kenkawakenkenke/tempescope/hardware/OpenTempescope/opentempescope.png

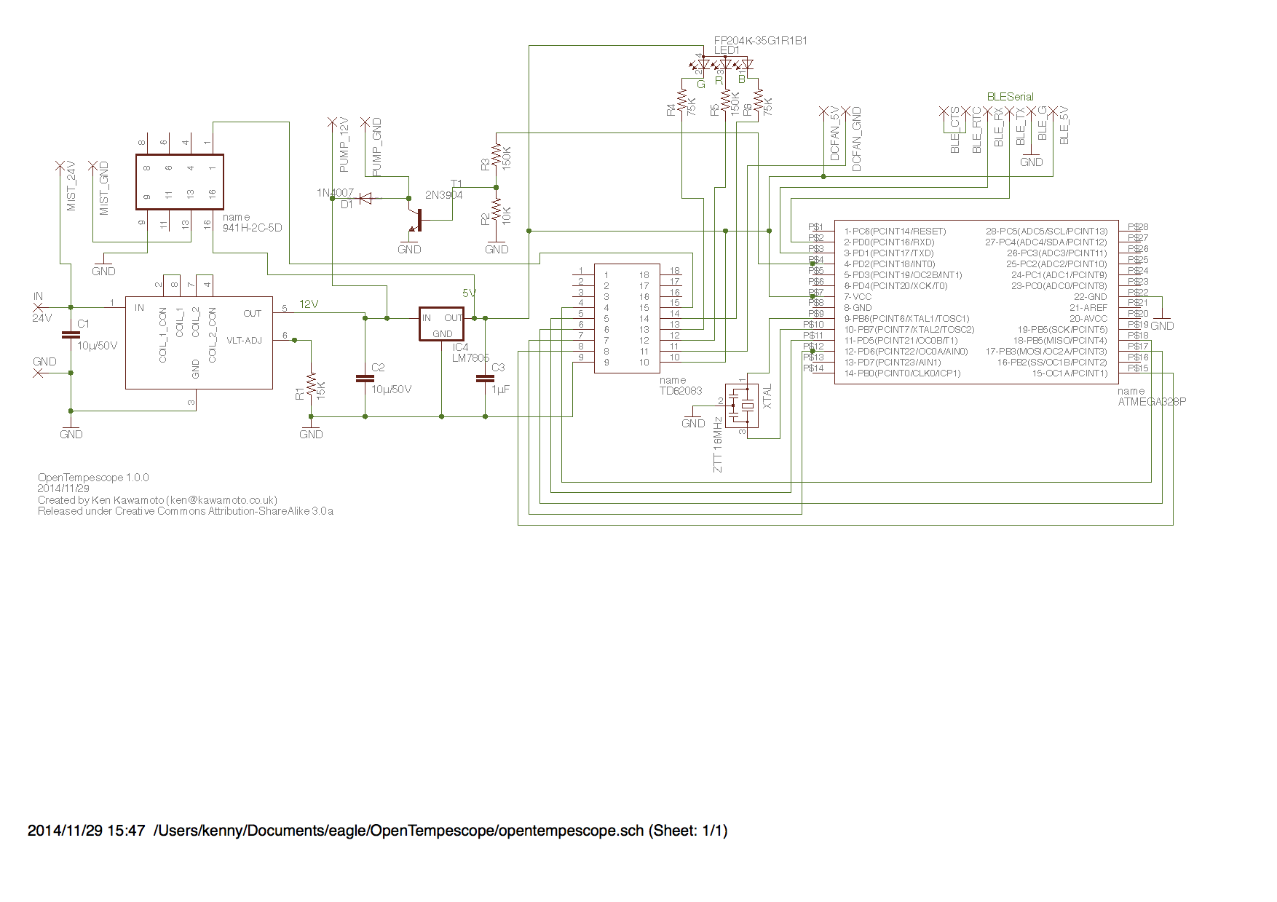
hardware/OpenTempescope/opentempescope.png
