kenkawakenkenke/tempescope/images/hardware/opentempescope_CAD_part1_of_2_r2.png

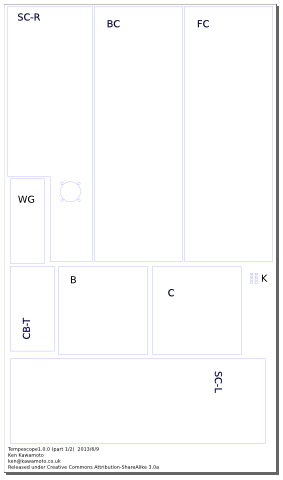
images/hardware/opentempescope_CAD_part1_of_2_r2.png
