kenkawakenkenke/tempescope/images/hardware/opentempescope_CAD_part2_of_2_r2.png

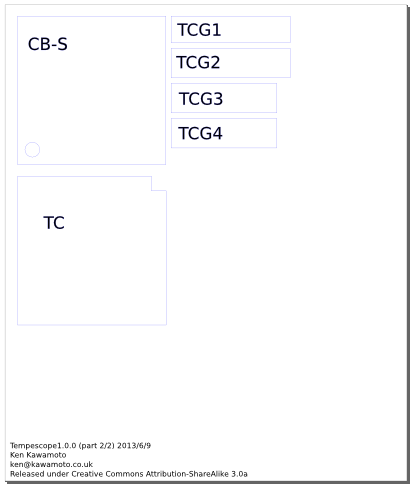
images/hardware/opentempescope_CAD_part2_of_2_r2.png
