kenkawakenkenke/tempescope/hardware/OpenTempescope/opentempescope.pdf

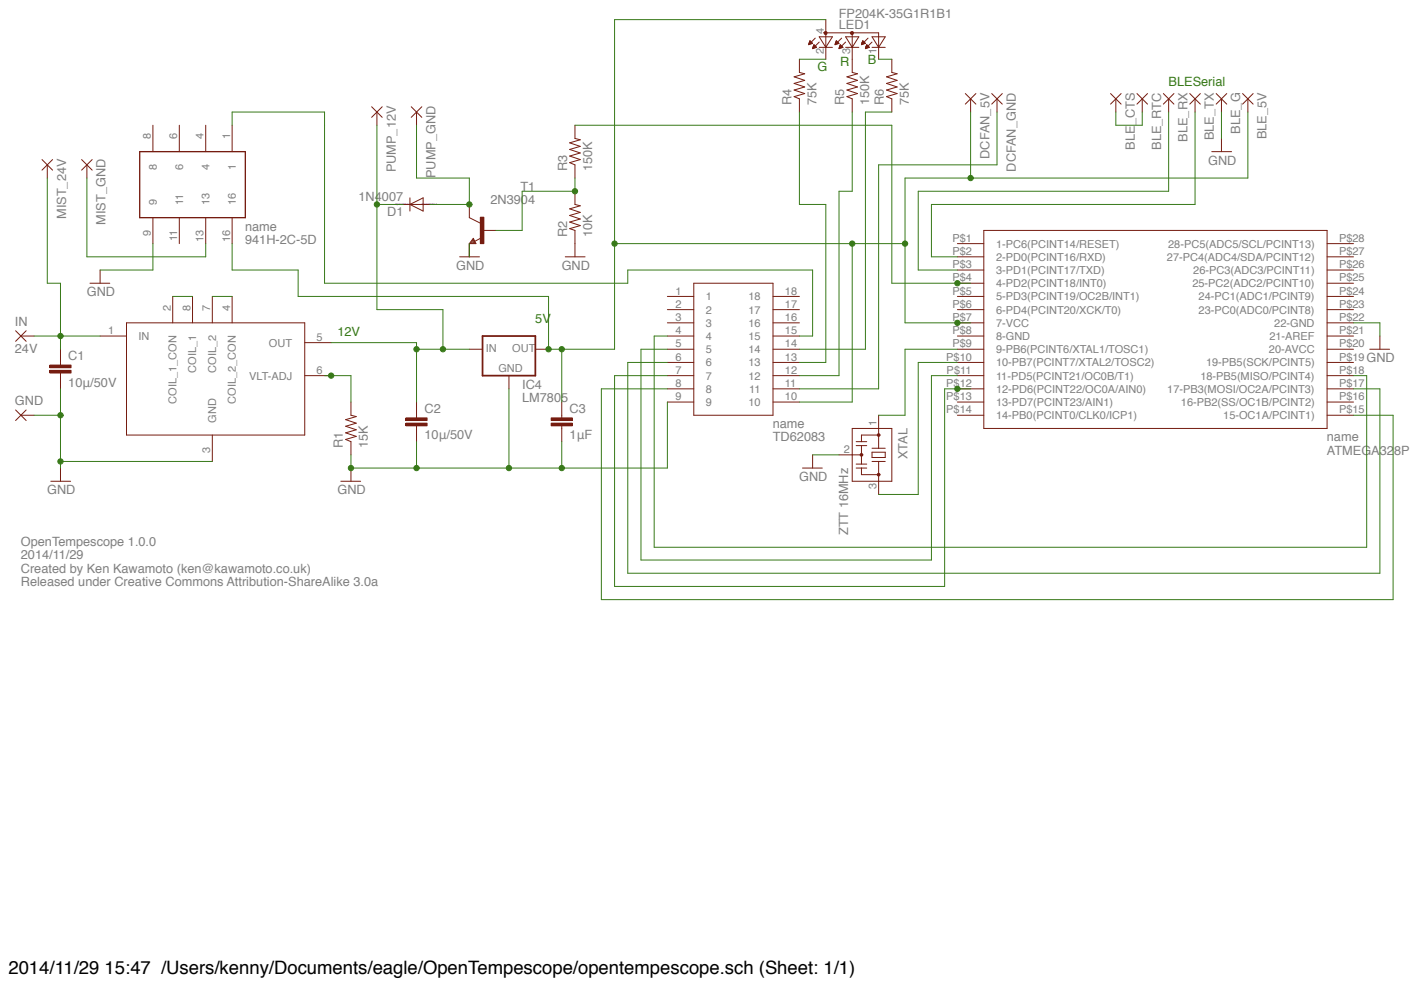
[picture p4: page 1]

OpenTempescope 1.0.0
Created by Ken Kawamoto (ken@kawamoto.co.uk)
Released under Creative Commons Attribution-ShareAlike 3.0a

2014/11/29 15:47 /Users/kenny/Documents/eagle/OpenTempescope/opentempescope.sch (Sheet: 1/1)
