kenkawakenkenke/tempescope/hardware/OpenTempescope/opentempescope.sch

## EAGLE design hardware/OpenTempescope/opentempescope.sch (2014-11-29)

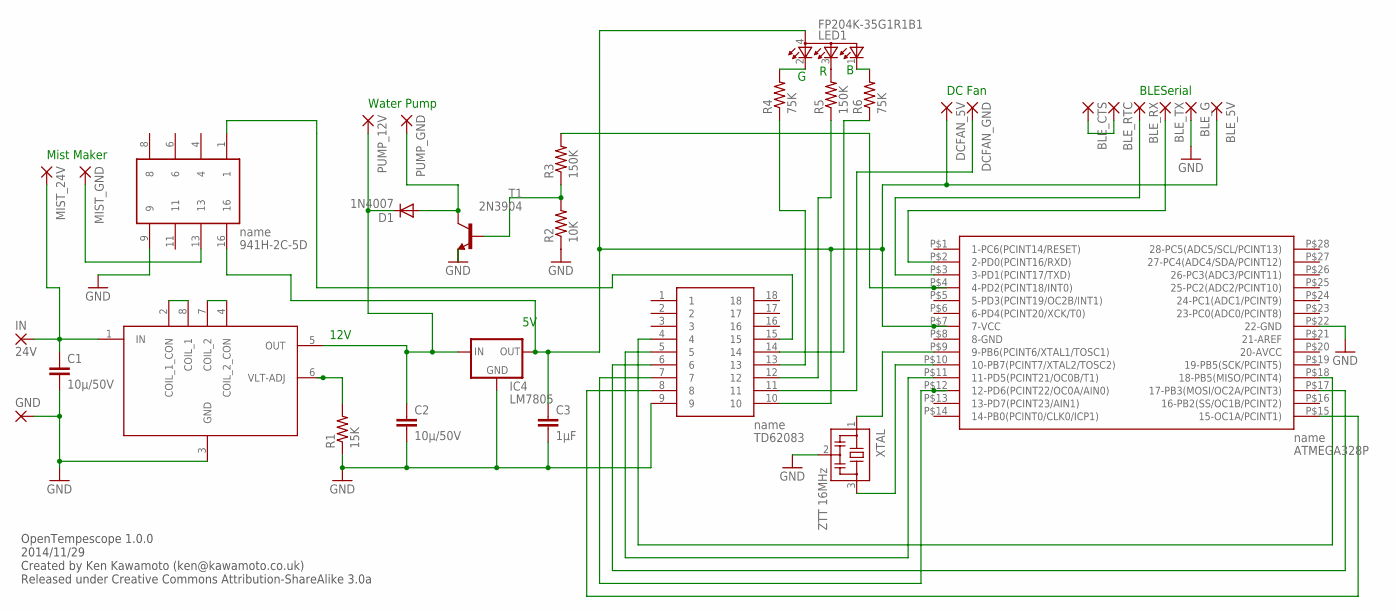
[picture p5: schematic opentempescope.sch]

Parts:
BLE_5V: 2,15/1,0
BLE_CTS: 2,15/1,0
BLE_G: 2,15/1,0
BLE_RTC: 2,15/1,0
BLE_RX: 2,15/1,0
BLE_TX: 2,15/1,0
C1, C2: 10μ/50V; C050-025X075
C3: 1μF; C050-025X075
D1: 1N4007; DO41-10
DCFAN_5V: 2,15/1,0
DCFAN_GND: 2,15/1,0
GND: 2,15/1,0
IC2: TD62083
IC4: LM7805; 78XXS
IN: 24V; 2,15/1,0
LED1: FP204K-35G1R1B1; GM1WA55311A
MIST_24V: 2,15/1,0
MIST_GND: 2,15/1,0
PUMP_12V: 2,15/1,0
PUMP_GND: 2,15/1,0
R1: 15K; 0309/12
R2: 10K; 0309/12
R3, R5: 150K; 0309/12
R4, R6: 75K; 0309/12
T1: 2N3904; TO92
U$1: HPH05001M
U$2: 941H-2C-5D
U$3: ATMEGA328P
XTAL: ZTT 16MHz; CSTCR6M

Connections:
GND: BLE_G.1, C2.2, C3.2, IC2.9, IC4.GND, R1.1, R2.1, T1.3 (E), U$2.9, U$3.P$22 (22-GND), XTAL.2
unnamed: C1.2, GND.1, U$1.3 (GND)
unnamed: C1.1, IN.1, MIST_24V.1, U$1.1 (IN)
unnamed: U$1.2 (COIL_1_CON), U$1.8 (COIL_1)
unnamed: U$1.4 (COIL_2_CON), U$1.7 (COIL_2)
unnamed: R1.2, U$1.6 (VLT-ADJ)
unnamed: D1.A, PUMP_GND.1, T1.1 (C)
unnamed: MIST_GND.1, U$2.13
unnamed: C2.1, D1.C, IC4.IN, PUMP_12V.1, U$1.5 (OUT)
unnamed: R2.2, R3.1, T1.2 (B)
unnamed: BLE_5V.1, C3.1, DCFAN_5V.1, IC2.10, IC4.OUT, LED1.4 (A), U$2.16, U$3.P$7 (7-VCC)
unnamed: LED1.2 (CRED), R4.2
unnamed: R3.2, U$3.P$4 (4-PD2(PCINT18/INT0))
unnamed: LED1.3 (CBLUE), R5.2
unnamed: LED1.1 (CGREEN), R6.2
unnamed: IC2.13, R4.1
unnamed: IC2.12, R5.1
unnamed: IC2.14, R6.1
unnamed: IC2.4, U$3.P$18 (18-PB5(MISO/PCINT4))
unnamed: IC2.5, U$3.P$11 (11-PD5(PCINT21/OC0B/T1))
unnamed: IC2.6, U$3.P$17 (17-PB3(MOSI/OC2A/PCINT3))
unnamed: IC2.7, U$3.P$12 (12-PD6(PCINT22/OC0A/AIN0))
unnamed: IC2.8, U$3.P$15 (15-OC1A/PCINT1))
unnamed: U$3.P$9 (9-PB6(PCINT6/XTAL1/TOSC1)), XTAL.1
unnamed: U$3.P$10 (10-PB7(PCINT7/XTAL2/TOSC2)), XTAL.3
unnamed: DCFAN_GND.1, IC2.11
unnamed: BLE_CTS.1, BLE_RTC.1
unnamed: BLE_RX.1, U$3.P$3 (3-PD1(PCINT17/TXD))
unnamed: BLE_TX.1, U$3.P$2 (2-PD0(PCINT16/RXD))

Notes on the sheet:
12V
BLESerial
OpenTempescope 1.0.0 2014/11/29 Created by Ken Kawamoto (ken@kawamoto.co.uk) Released under Creative Commons Attribution-ShareAlike 3.0a
DC Fan
Water Pump
Mist Maker
