kenkawakenkenke/tempescope/(threads)

Thread 6 (2015-09-09):

More descriptive parts list

joejuzl, 2015-09-09:
Hi there,

I was wondering if you could make the parts list a bit more descriptive.
It's hard to know what some components are, e.g. HPH05001M, especially when in a different country.

Thanks!

Joe

sergio-daniels, 2015-09-09:
This is kind a transformer which will convert the input voltage to 12 volt

joejuzl, 2015-09-10:
Thanks Sergio!

Unfortunately I can't see the facebook picture, maybe it's only shared with your friends?

Also, do you happen to know what the 941H-2C-5D, 78XXS and, TD62083 are used for?

Thanks again,

Joe

sergio-daniels, 2015-09-10:
Hi Joel,
i'm not a FB friend. Have a look at my github repository wiki you find all the Images there as well.
https://github.com/sergio-daniels/tempescope/wiki/0.1-Images
941H-2C-5D is just a relay you can use any relay which matches the voltage for the coil and the voltage to Switch. 78xxS is the voltage Regulator which gives you the 5 Volt for your logic. The TD62083 is your darlington sink Driver to protect your microcontroller Outputs so you can draw more current wich you need.
Kind regards
Sergio

joejuzl, 2015-09-10:
Thanks you again Sergio, you've been really helpful. I am looking to start building soon.
The pictures are great by the way, looks like you've done a really good job.

Closed 2015-09-12.

Thread 8 (2016-01-25):

Missing opentempescope.brd?

ATamalonis, 2016-01-25:
Presumably it doesn't matter how you lay out the components on the board, but does anyone have a .brd file from EAGLE for a board layout? If not, I might learn how to use EAGLE and reverse engineer one from the photo of your finished board. In the mean time I need to order all the parts and breadboard everything.

Thread 9 (2016-09-12):

APK /  Android Support

Bixel925, 2016-09-12:
I haven't found anything on how to get Tempescope to work with Android. Is there a simple way to use Tempescope with an Android device?

ATamalonis, 2016-09-12:
I think you'd have to write your own app on Android; last I checked there was no Android app, but maybe someone has made one. It uses Bluetooth, so there should be some generic pre-made apps to talk to Bluetooth devices and activate their outputs which could serve as a starting point or proof of concept before you start writing a lot of code. I've looked at one by Adafruit for iOS before, but didn't use it much.

Bixel925, 2016-09-12:
Well nuts. I'm afraid that I've no idea where to even begin with writing an Android app.

LukeSkywalker856, 2017-04-19:
Yeah well me too, I know fucking shit about writing programs for apps. For me to write an app would be like, getting my own fuel for my car, but first, I'd have to make a oil drill rig, before that, I'd have to get steal to make the rig, I'd have to make the tools to make the rig, and so on and so forth. So yeah, this is all pointless for me.

Thread 11 (2018-02-23):

Waterproofness of fan

signoutwastaken, 2018-02-23:
How do you make sure the water can't get to the fan?

surety, 2020-06-11:
Have you figure out how to do this? I plan on building this but i wonder if the fan will be an issue
