kenkawakenkenke/tempescope/OpenTempescope/OpenTempescope/OpenTempescope.ino

/*
  Tempescope.ino - Main source file for OpenTempescope hardware
  Released as part of the OpenTempescope project - http://tempescope.com/opentempescope/
  Copyright (c) 2013 Ken Kawamoto.  All right reserved.

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
  You should have received a copy of the GNU Lesser General Public
  License along with this library; if not, write to the Free Software
  Foundation, Inc., 51 Franklin St, Fifth Floor, Boston, MA  02110-1301  USA
*/

#include <EEPROM.h>
#include "Weather.h"
#include "PinController.h"
#include "LightController.h"
#include "FanStateController.h"
#include "PumpStateController.h"
#include "MistStateController.h"
#include "LightStateController.h"
#include "AnimationController.h"

#define FLAG_SAVED_EXISTS 0xB4
#define PIN_RX 8
//pins
#define PIN_R 11
#define PIN_G 6
#define PIN_B 5
#define PIN_MIST 13
#define PIN_FAN 9
#define PIN_PUMP 2

/*****************
Low level controllers
******************/
PinController  *mistController,
               *fanController,
               *pumpController;
LightController *lightController;

/*****************
State controllers
******************/
FanStateController *fanStateController;
PumpStateController *pumpStateController;
MistStateController *mistStateController;
LightStateController *lightStateController;

AnimationController *demoAnimation;
AnimationController *singleWeatherAnimation;
AnimationController *nothingAnimation;
AnimationController *savedAnimation=NULL;
AnimationController *currentAnimation;
void setup(){
  
  Serial.begin(9600);
  
  //low level controllers
  mistController=new PinController(PIN_MIST);
  fanController=new PinController(PIN_FAN);
  pumpController=new PinController(PIN_PUMP);
  lightController=new LightController(PIN_R,PIN_G,PIN_B);
  
  //initializing (flash red 5 times)
  for(int i=0;i<5;i++){
   lightController->setRGB(255,0,0);
   delay(100);
   lightController->setRGB(0,0,0);
   delay(50);
  }
 
  //state controllers
  fanStateController=new FanStateController(fanController);
  pumpStateController=new PumpStateController(pumpController);
  mistStateController=new MistStateController(mistController);
  lightStateController=new LightStateController(lightController);
  
  
  //setup demo animation
  demoAnimation=new AnimationController();
  {
    //original demo
    demoAnimation->setNumFrames(21);
    demoAnimation->setFrameAt(0,5000, Weather(0,kClear,false));
    demoAnimation->setFrameAt(1,5000, Weather(0.5,kClear,false));
    demoAnimation->setFrameAt(2,5000, Weather(1,kCloudy,false));
    demoAnimation->setFrameAt(3,5000, Weather(1,kCloudy,false));
    demoAnimation->setFrameAt(4,5000, Weather(1,kCloudy,false));
    demoAnimation->setFrameAt(5,5000, Weather(1,kCloudy,false));
    demoAnimation->setFrameAt(6,5000, Weather(1,kRain,false));
    demoAnimation->setFrameAt(7,5000, Weather(1,kRain,false));
    demoAnimation->setFrameAt(8,5000, Weather(1,kRain,false));
    demoAnimation->setFrameAt(9,5000, Weather(1,kRain,false));
    demoAnimation->setFrameAt(10,5000, Weather(1,kCloudy,false));
    demoAnimation->setFrameAt(11,5000, Weather(1,kCloudy,false));
    demoAnimation->setFrameAt(12,5000, Weather(1,kClear,false));
    demoAnimation->setFrameAt(13,5000, Weather(1,kClear,false));
    demoAnimation->setFrameAt(14,5000, Weather(0.5,kRain,false));
    demoAnimation->setFrameAt(15,5000, Weather(0,kRain,false));
    demoAnimation->setFrameAt(16,5000, Weather(0,kRain,true));
    demoAnimation->setFrameAt(17,5000, Weather(0,kRain,true));
    demoAnimation->setFrameAt(18,5000, Weather(0,kRain,true));
    demoAnimation->setFrameAt(19,5000, Weather(0,kClear,true));
    demoAnimation->setFrameAt(20,5000, Weather(0,kClear,false));
    
  }
  
  
  //for showing single weather
  singleWeatherAnimation=new AnimationController();
  {
    singleWeatherAnimation->setNumFrames(1);
    singleWeatherAnimation->setFrameAt(0,3000,Weather(0,kClear,false));
    
  }
  
  //for doing nothing
  nothingAnimation=new AnimationController();
  {
    nothingAnimation->setNumFrames(1);
    nothingAnimation->setFrameAt(0,10000,Weather(0,kClear,false));
  }
  
  
  //load saved animation
  boolean needsInitializingEEPROM=true;
  if(EEPROM.read(0)==FLAG_SAVED_EXISTS){
//    Serial.println("saved flag up");
    savedAnimation=AnimationController::readFromEEPROM();//new AnimationController();
    
    //check saved animation(if exists) is sane
    int numFrames=savedAnimation->numFrames();
    if(numFrames>0 && numFrames<250){ //arbitrary...
      //clean up
      for(int i=0;i<numFrames;i++){
        savedAnimation->frameAtIndex(i)->weather.validateAndFix();
      }
      needsInitializingEEPROM=false;
    }
  }
  
  if(needsInitializingEEPROM){
    if(savedAnimation==NULL)
      savedAnimation=new AnimationController();
    savedAnimation->setNumFrames(1);
    Weather weather(0,kClear,false);
    savedAnimation->setFrameAt(0,3000,weather);
    
    EEPROM.write(1,1); //save length 
    int sizeOfWeather=sizeof(AnimationFrame);
    char *frame=(char *)(savedAnimation->frameAtIndex(0));
    for(int j=0;j<sizeOfWeather;j++)
      EEPROM.write(2+j,*(frame+j));
    EEPROM.write(0,FLAG_SAVED_EXISTS);
  }
  
  currentAnimation=singleWeatherAnimation;
  
  if(savedAnimation->numFrames()>0){
    lightController->setRGB(0,0,255);
    currentAnimation=savedAnimation;
    currentAnimation=demoAnimation;
  }else
  {
    lightController->setRGB(0,255,0);
    currentAnimation=demoAnimation;
  }
  
  currentAnimation->start();
  delay(1000);
  lightController->setRGB(0,0,0);
  
  Serial.println("start");
}

void doWeather(Weather weather){
  if(weather.lightning())
    lightStateController->doAction(ACTION_LIGHT_LNG_ON);
  else{
    lightStateController->setPNoon(weather.pNoon());
    lightStateController->doAction(ACTION_LIGHT_LNG_OFF);
  }
  
  switch(weather.weatherType()){
    case kClear:
    {
    pumpStateController->doAction(ACTION_PUMP_OFF);
    fanStateController->doAction(ACTION_FAN_OFF);
    mistStateController->doAction(ACTION_MIST_OFF);
    }break;
    case kRain:
    {
    pumpStateController->doAction(ACTION_PUMP_ON);
    fanStateController->doAction(ACTION_FAN_OFF);
    mistStateController->doAction(ACTION_MIST_OFF);
    }break;
    case kCloudy:
    {
    pumpStateController->doAction(ACTION_PUMP_OFF);
    fanStateController->doAction(ACTION_FAN_ON);
    mistStateController->doAction(ACTION_MIST_ON);
    }break;
  }
}


byte readBuf[21];
int readPacket(byte buf[],int length){
  int idx=0;
  long tEnd=millis()+1000;
  while(millis()<tEnd && idx<length){
    if(Serial.available()>0){
      int k=Serial.read();
      buf[idx++]=k;
    }
  }
  return idx==length;
}

void loop(){
  if (Serial.available()>0)
  {
    char func=Serial.read();
    boolean err=0;
    
    switch(func){
      case 'C':
        //connecting!
        
        //read and ignore (C)ONNECT
        readPacket(readBuf, 7);
        break;
      case 'D':
        //disconnecting!
        //read and ignore (D)ISCONNECT
        readPacket(readBuf, 10);
        break;
        
      case 'z':
        //off
//        Serial.println("off");
        currentAnimation=nothingAnimation;
        currentAnimation->start();
        
      break;
      
      case 'r':
        
        //play single weather
        if(readPacket(readBuf, 3)){
          double pNoon= readBuf[0]/255.;
          int weatherType= readBuf[1];
          int lightning=readBuf[2];
          
          Weather newWeather(pNoon, (WeatherType)weatherType, lightning);
          
          newWeather.validateAndFix();
    
          singleWeatherAnimation->setFrameAt(0,3000,newWeather);
          
          currentAnimation=singleWeatherAnimation;
          currentAnimation->start();
          
        }else{
          err=1;
        }
      break;
      
      case 'd':
        //play demo
//        Serial.println("play demo");
        currentAnimation=demoAnimation;
        currentAnimation->start();
      break;
      
      case 'l':
        //play saved animation
//          Serial.println("play saved");
        currentAnimation=savedAnimation;
        currentAnimation->start();
      break;
      
      case 's':
        //save a frame
        if(readPacket(readBuf, 6)){
          
          int idx=readBuf[0];
          long dur= (((long)readBuf[1])<<8)|readBuf[2];
          if(dur>60000)
            dur=60000; //just in case
          if(dur<=0)
            dur=1;
            
          double pNoon= readBuf[3]/255.;
          int weatherType= readBuf[4];
          int lightning=readBuf[5];
          
          Weather newWeather(pNoon, (WeatherType)weatherType, lightning);
          newWeather.validateAndFix();
          
          //copy to frame
          savedAnimation->setFrameAt(idx,dur,newWeather);
          
          int sizeOfWeather=sizeof(AnimationFrame);
          char *frame=(char *)(savedAnimation->frameAtIndex(idx));
          int baseIdx= 2+ idx*sizeOfWeather;
          for(int j=0;j<sizeOfWeather;j++)
            EEPROM.write(baseIdx+j,*(frame+j));
            
//          Serial.print("save: ");
//          Serial.print((int)idx);
//          Serial.print(" ");
//          Serial.print(dur);
//          Serial.print(" ");
//          newWeather.print();
//  digitalWrite(13,LOW);
          
        }else{
          err=1;
        }
      break;
      
      
      case 'f':
        //length of animation frame
        if(readPacket(readBuf, 1)){
          int length=readBuf[0];
          
          savedAnimation->setNumFrames(length);
      
          EEPROM.write(1,length); //save
          //save to "saved"
          lightController->setRGB(255,255,0);
          savedAnimation->start();
          
        }else{
          err=1;
        }
      break;
      
      default:
        err=1;
    }
    if(err){
      while(Serial.available()>0) //kill everything in Socket
        Serial.read();
    }
    
  }
  
  doWeather(currentAnimation->getCurrentWeather());
}
