kenkawakenkenke/tempescope/(commit log)

2013-06-08 Added CAD svgs
2013-06-08 Added schematics
    [tempescope.fzz]
2013-06-23 added tempescope remote schematics
    [tempescope_remote_quick.fzz]
2014-11-29 initial update for OpenTempescope
    - updated schematics to EAGLE format
    - updated schematics to support tempescope
    - killed Tempescope Remote (we have BLE so we don’t need this anymore)
    - updated all license references to OpenTempescope
    [opentempescope.sch, tempescope.fzz, tempescope_remote_quick.fzz]
2014-11-29 fixed directory structures
    - removed all references to “tempescope”, changed to “OpenTempescope”
    [AnimationController.cpp, AnimationController.h, FanStateController.cpp, FanStateController.h, LightController.cpp, LightController.h, LightStateController.cpp, LightStateController.h]
2014-11-29 added iOS control demo
    - added TempescopeControlDemo for controlling OpenTempescope from an
    iOS device
